Raghul-PK/GPS_Receiver/Final Prototype/Schematic/PCB_PCB_GPS_SingleSidePCB_22-02-24_4-copy_2024-06-06.png

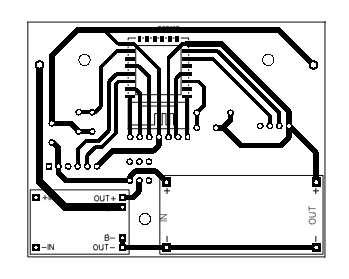
Final Prototype/Schematic/PCB_PCB_GPS_SingleSidePCB_22-02-24_4-copy_2024-06-06.png
