Raghul-PK/GPS_Receiver/Final Prototype/Schematic/Schematic_GPS_SingleSidePCB_05-03-24_2024-06-06.png

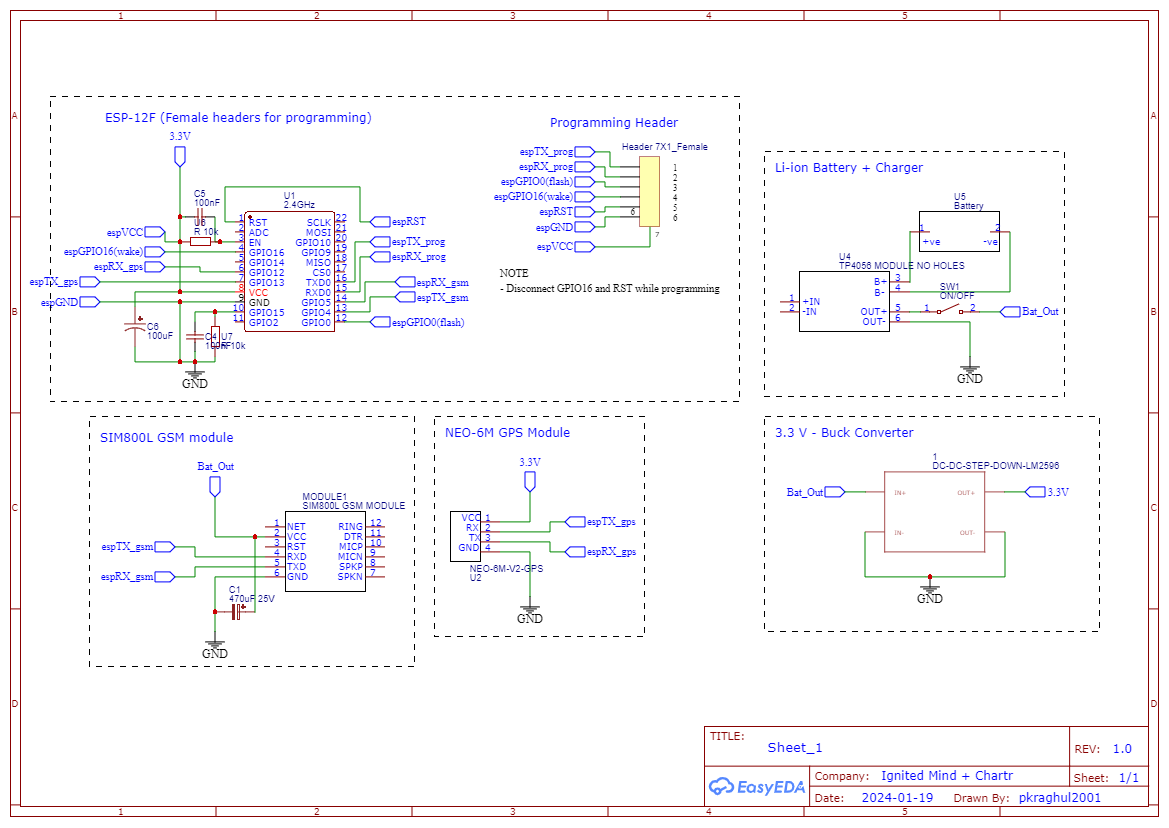
Final Prototype/Schematic/Schematic_GPS_SingleSidePCB_05-03-24_2024-06-06.png
