Raghul-PK/GPS_Receiver/Final Prototype/Enclosure Design/Snap Fit/GPS_Snap_Body.stl

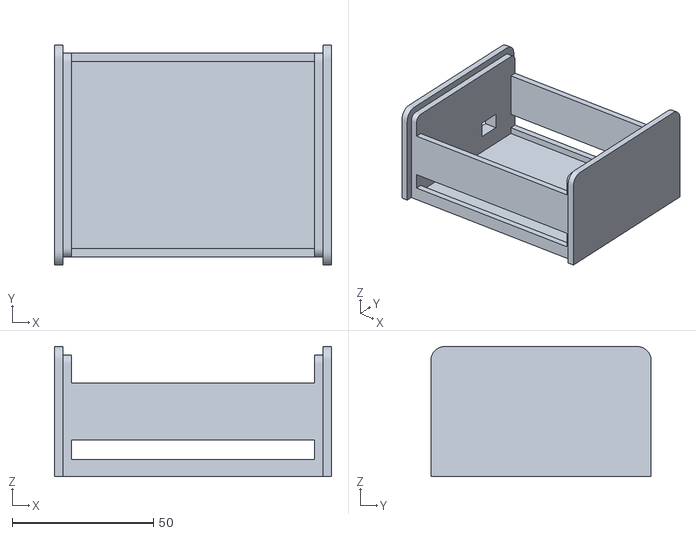
[picture p7: CAD file, 2024-06-06]
Final Prototype/Enclosure Design/Snap Fit/GPS_Snap_Body.stl
98.0 x 78.0 x 46.0
