Raghul-PK/GPS_Receiver/Final Prototype/Enclosure Design/Snap Fit/GPS_Snap_Cover2.stl

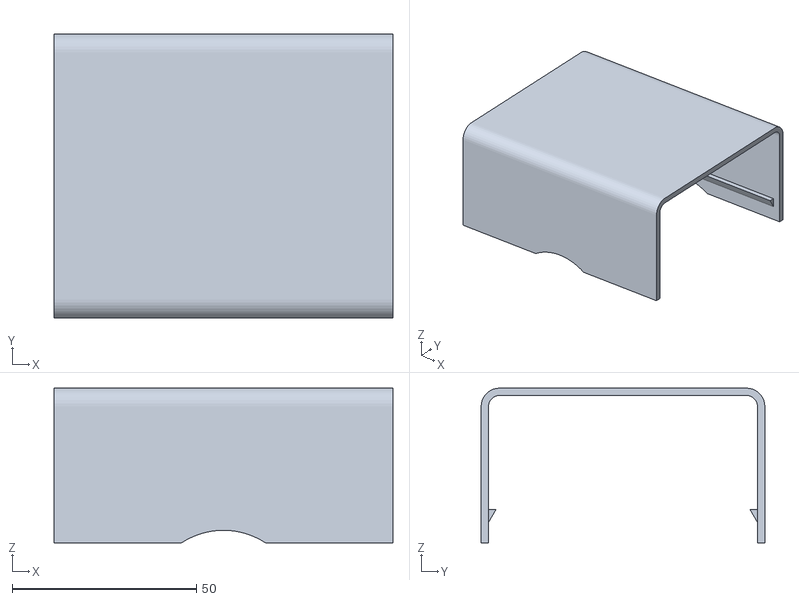
[picture p8: CAD file, 2024-06-06]
Final Prototype/Enclosure Design/Snap Fit/GPS_Snap_Cover2.stl
92.0 x 77.0 x 42.0
