Raghul-PK/GPS_Receiver/Final Prototype/Enclosure Design/Snap Fit/GPS_Snap_Cover1.stl

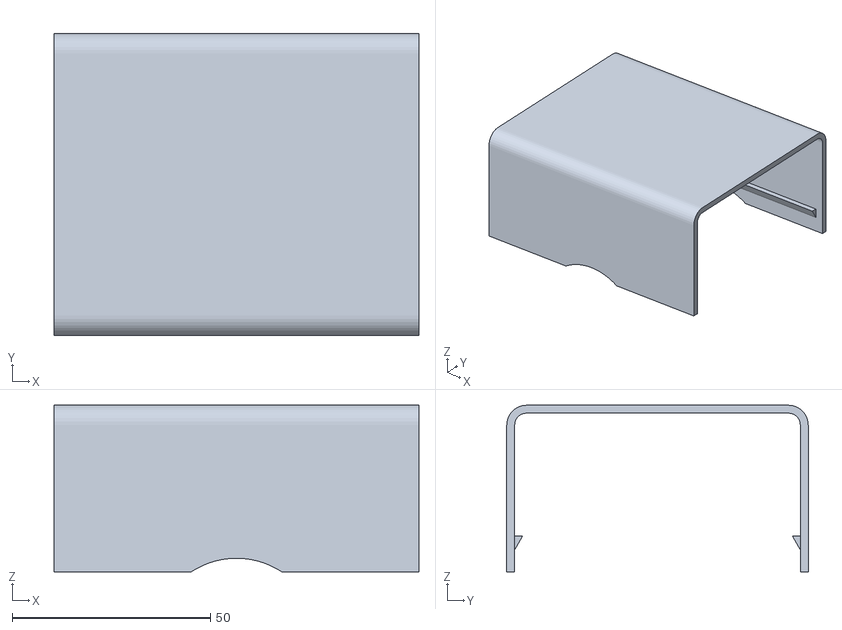
[picture p9: CAD file, 2024-06-06]
Final Prototype/Enclosure Design/Snap Fit/GPS_Snap_Cover1.stl
92.0 x 76.0 x 42.0
