Raghul-PK/GPS_Receiver/Final Prototype/Enclosure Design/Normal (Nut-Bolt based)/GPS_Enclosure_V1_Cover.stl

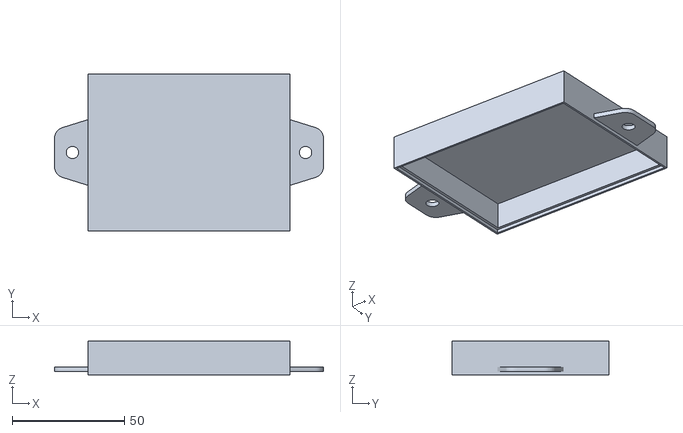
[picture p10: CAD file, 2024-06-06]
Final Prototype/Enclosure Design/Normal (Nut-Bolt based)/GPS_Enclosure_V1_Cover.stl
120.0 x 70.0 x 15.0
