Raghul-PK/GPS_Receiver/Final Prototype/Enclosure Design/Normal (Nut-Bolt based)/GPS_Enclosure_V1_Body.stl

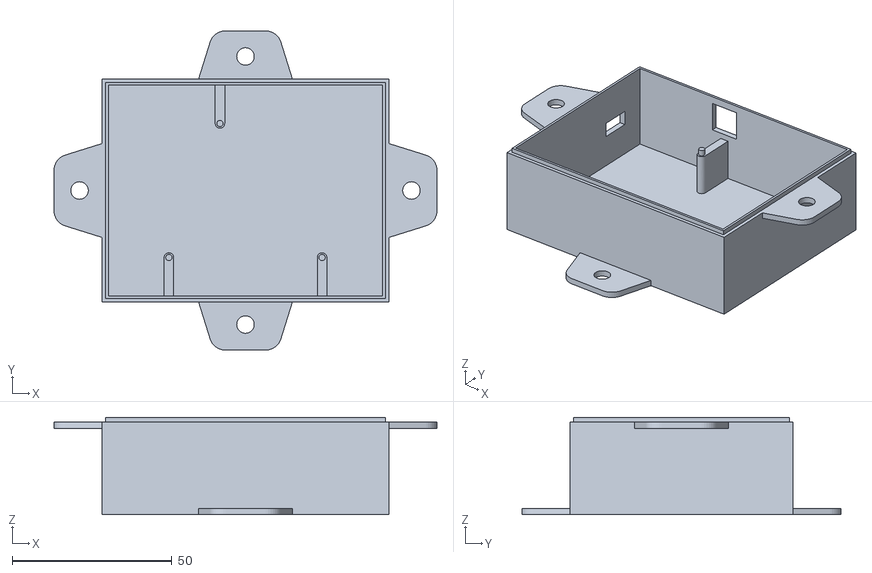
[picture p11: CAD file, 2024-06-06]
Final Prototype/Enclosure Design/Normal (Nut-Bolt based)/GPS_Enclosure_V1_Body.stl
120.0 x 100.0 x 30.5
