Raghul-PK/GPS_Receiver/(commit log)

2024-01-04 Putting data from GSM to Firebase DB
    Copied Code from Internet.
    Ref : https://how2electronics.com/gsm-arduino-communication-with-firebase-or-thingspeak/
2024-02-21 Create V2... Did minor changes based on understanding of TinyGPS, TinyGSM and ArduinoHTTPClient libraries
